matt-garman/mcu-relay-controller/pcb/attiny_v1.1/attiny_relay_bypass_v1.1.BOM.pdf

Ref | Qty | Value | Footprint
C1 | 1 | 10uF | Capacitor_THT:CP_Radial_D5.0mm_P2.50mm
C2 C4 | 2 | 100n | Capacitor_THT:C_Rect_L7.2mm_W3.0mm_P5.00mm_FKS2_FKP2_MKS2_MKP2
C3 | 1 | 10nF | Capacitor_THT:C_Rect_L7.2mm_W2.5mm_P5.00mm_FKS2_FKP2_MKS2_MKP2
R1 R2 R3 | 3 | 1k | Resistor_THT:R_Axial_DIN0207_L6.3mm_D2.5mm_P7.62mm_Horizontal
CLR1 | 1 | 10-15k | Resistor_THT:R_Axial_DIN0207_L6.3mm_D2.5mm_P7.62mm_Horizontal
D1 | 1 | 1N5817 | Diode_THT:D_DO-35_SOD27_P7.62mm_Horizontal
LED1 | 1 | LOW CURRENT/ULTRA BRIGHT mng_footprints:OffboardWireHoles_1x02_P2.54mm
K1 | 1 | Relay_DTDT_A-4.5W-K_separated mng_footprints:Relay_DPDT_A-4.5W-K
Q1 | 1 | 2N7000 | Package_TO_SOT_THT:TO-92_Inline_Wide
SW1 | 1 | SW_SPST | mng_footprints:OffboardWireHoles_1x02_P2.54mm
U1 | 1 | LP2950-5.0_TO92Package_TO_SOT_THT:TO-92_Wide
U2 | 1 | ATtiny85-20P | Package_DIP:DIP-8_W7.62mm
