matt-garman/mcu-relay-controller/pcb/attiny_v1.0/attiny_relay_bypass_v1.0_BOM.pdf

ATtiny relay bypass PCB v1.0

Ref | Qty | Value
C1 | 1 | 10uF
C2 | 1 | 100n
C3 | 1 | 1nF
D1 | 1 | 1N5817
LED1 | 1 | LOW CURRENT/ULTRA BRIGHT
R1 R2 | 2 | 1k
R3 | 1 | 10k
CLR1 | 1 | 10-15k
SW1 | 1 | SW_SPST
Q1 | 1 | 2N3904
U1 | 1 | LP2950-5.0_TO92
U2 | 1 | ATtiny85 (or ATtiny13A)
K1 | 1 | TQ2-L-5V (or AL5WN-K)
