matt-garman/mcu-relay-controller/pcb/attiny_smd_v5.x/attiny_relay_bypass_v5.1.schematic.pdf

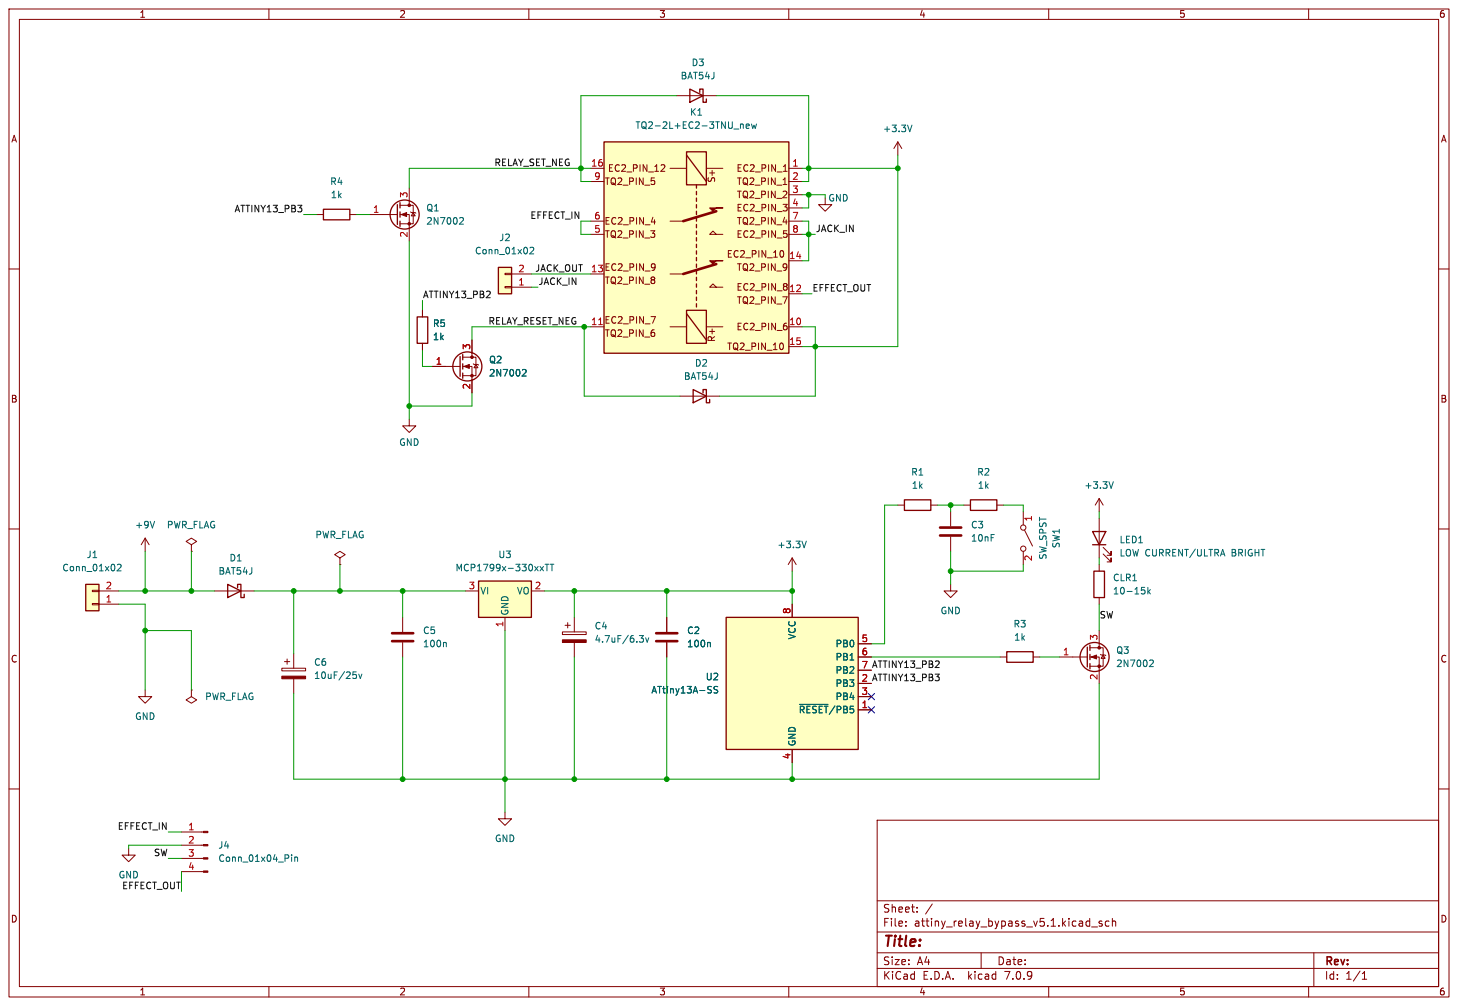
[picture p1: page 1]

LOW CURRENT/ULTRA BRIGHT
