matt-garman/mcu-relay-controller/pcb/pic10f32x_v3.0/pic10f320_relay_bypass_v3.0_schematic.pdf

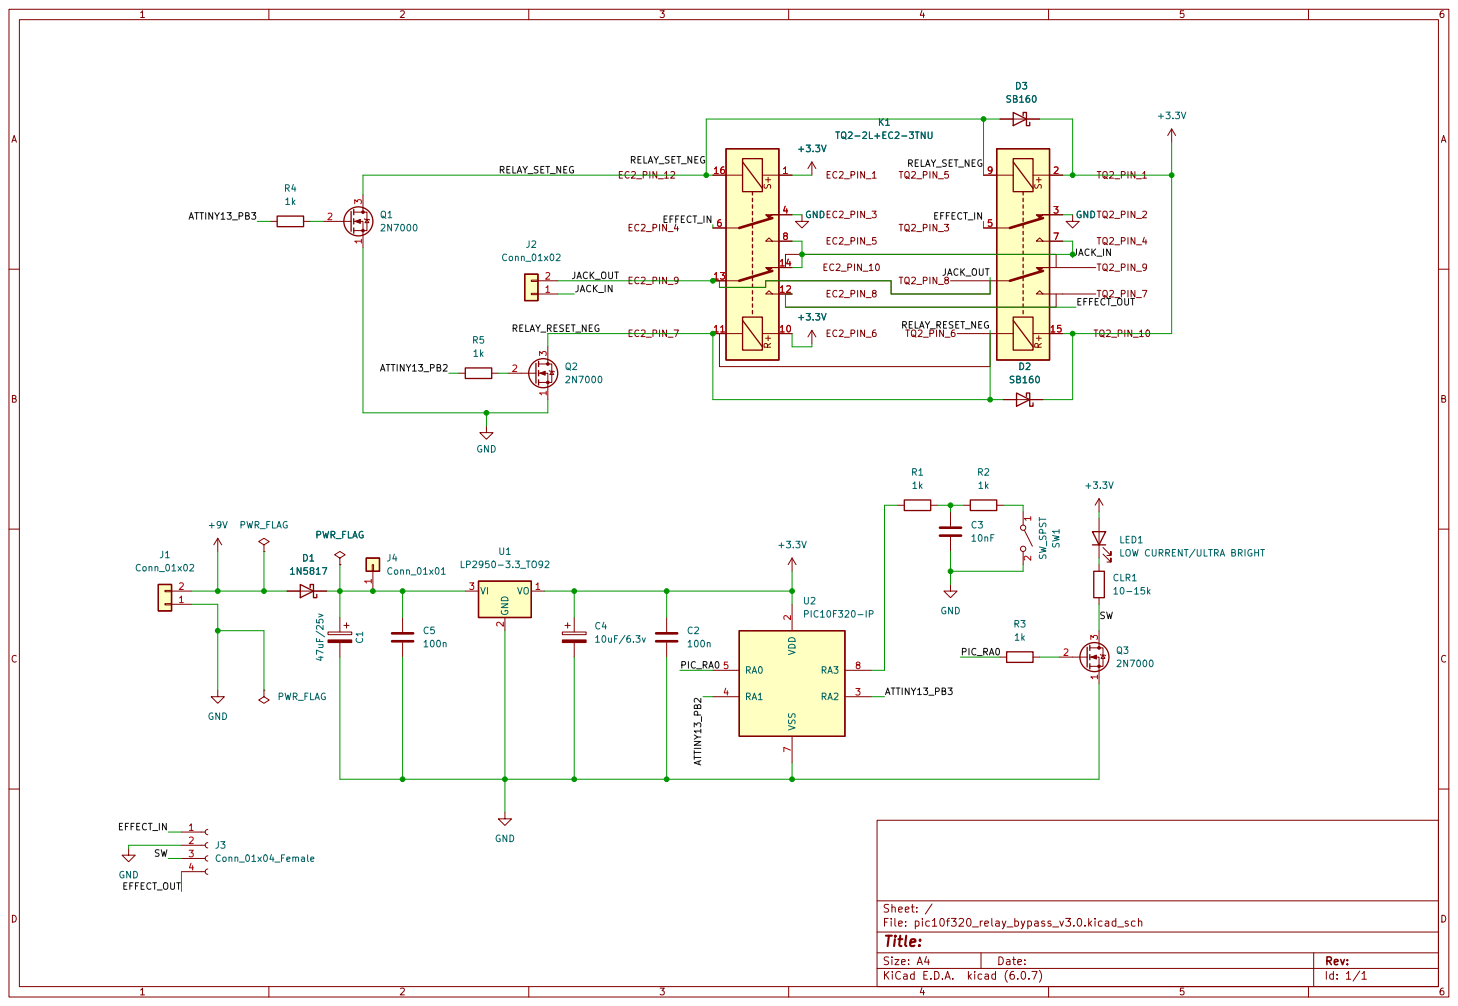
[picture p2: page 1]

LED1
LOW CURRENT/ULTRA BRIGHT
