matt-garman/mcu-relay-controller/pcb/attiny_v2.0/attiny_relay_bypass_v2.0_schematic.pdf

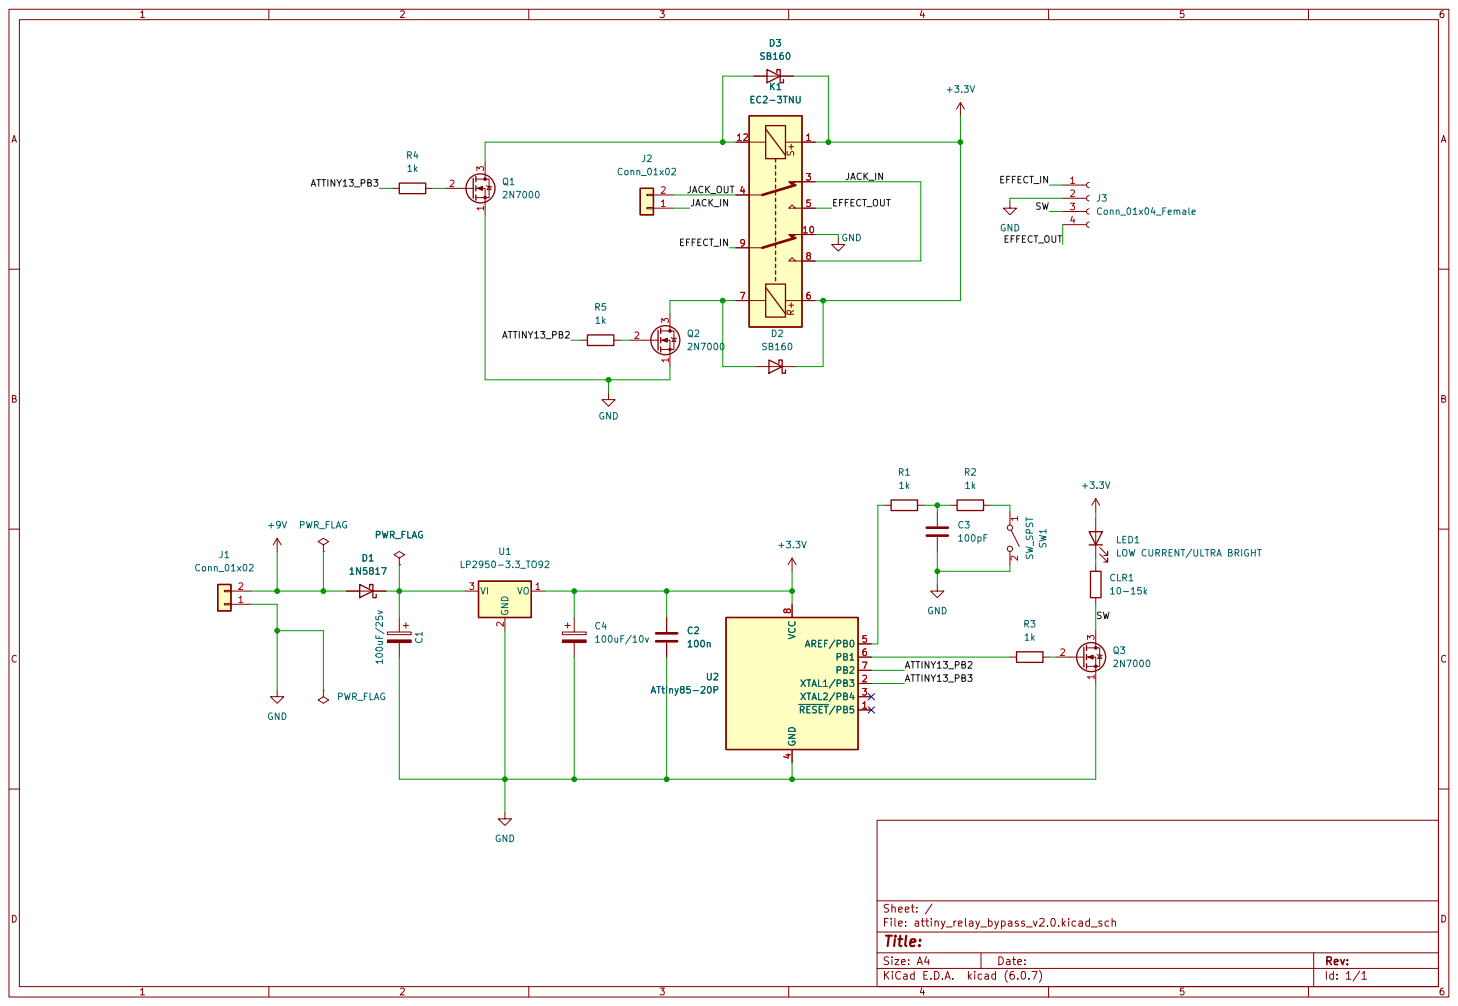
[picture p3: page 1]

LOW CURRENT/ULTRA BRIGHT R5
