matt-garman/mcu-relay-controller/pcb/pic10f32x_v3.0/pic10f32x_relay_bypass_v3.0_BOM.pdf

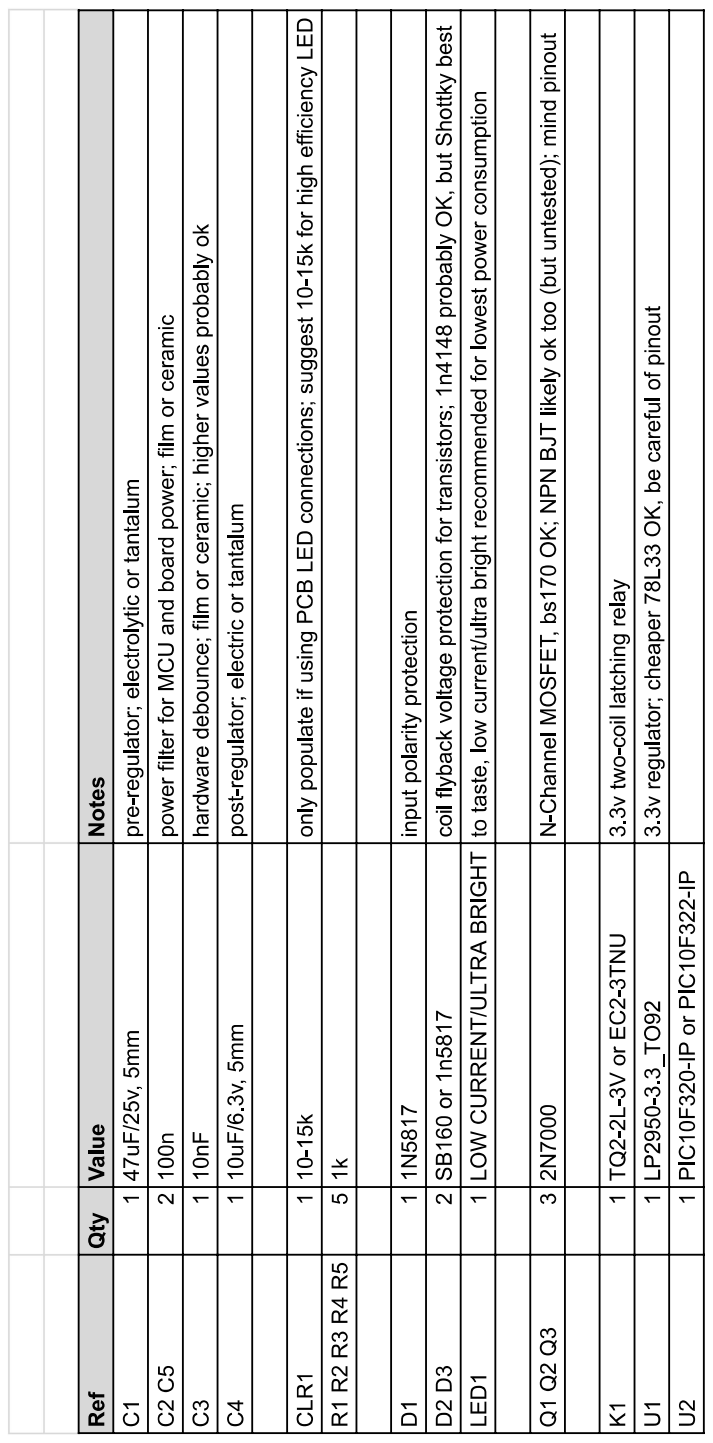
[picture p4: page 1]
