matt-garman/mcu-relay-controller/pcb/attiny_v2.0/attiny_relay_bypass_v2.0_BOM.pdf

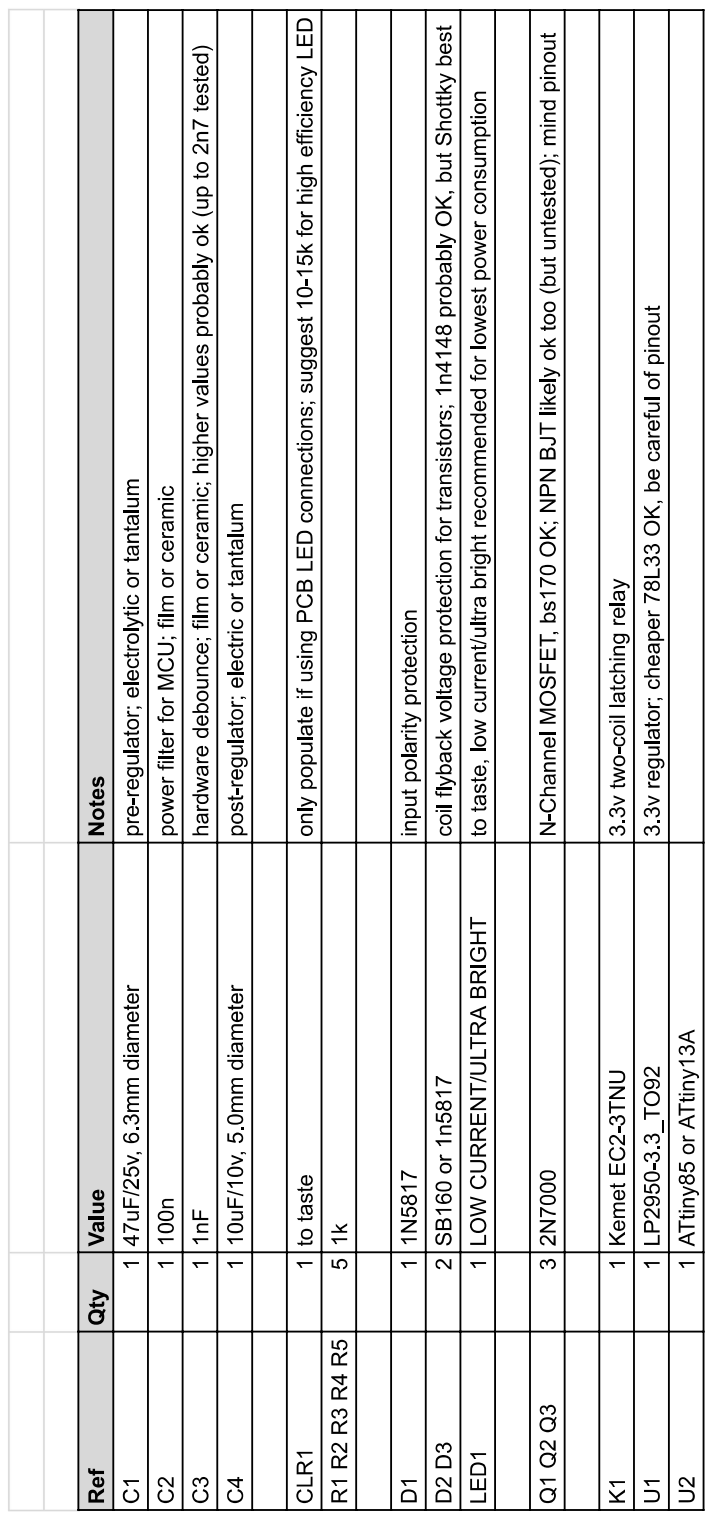
[picture p5: page 1]
