matt-garman/mcu-relay-controller/pcb/attiny_v1.1/attiny_relay_bypass_v1.1_schematic.pdf

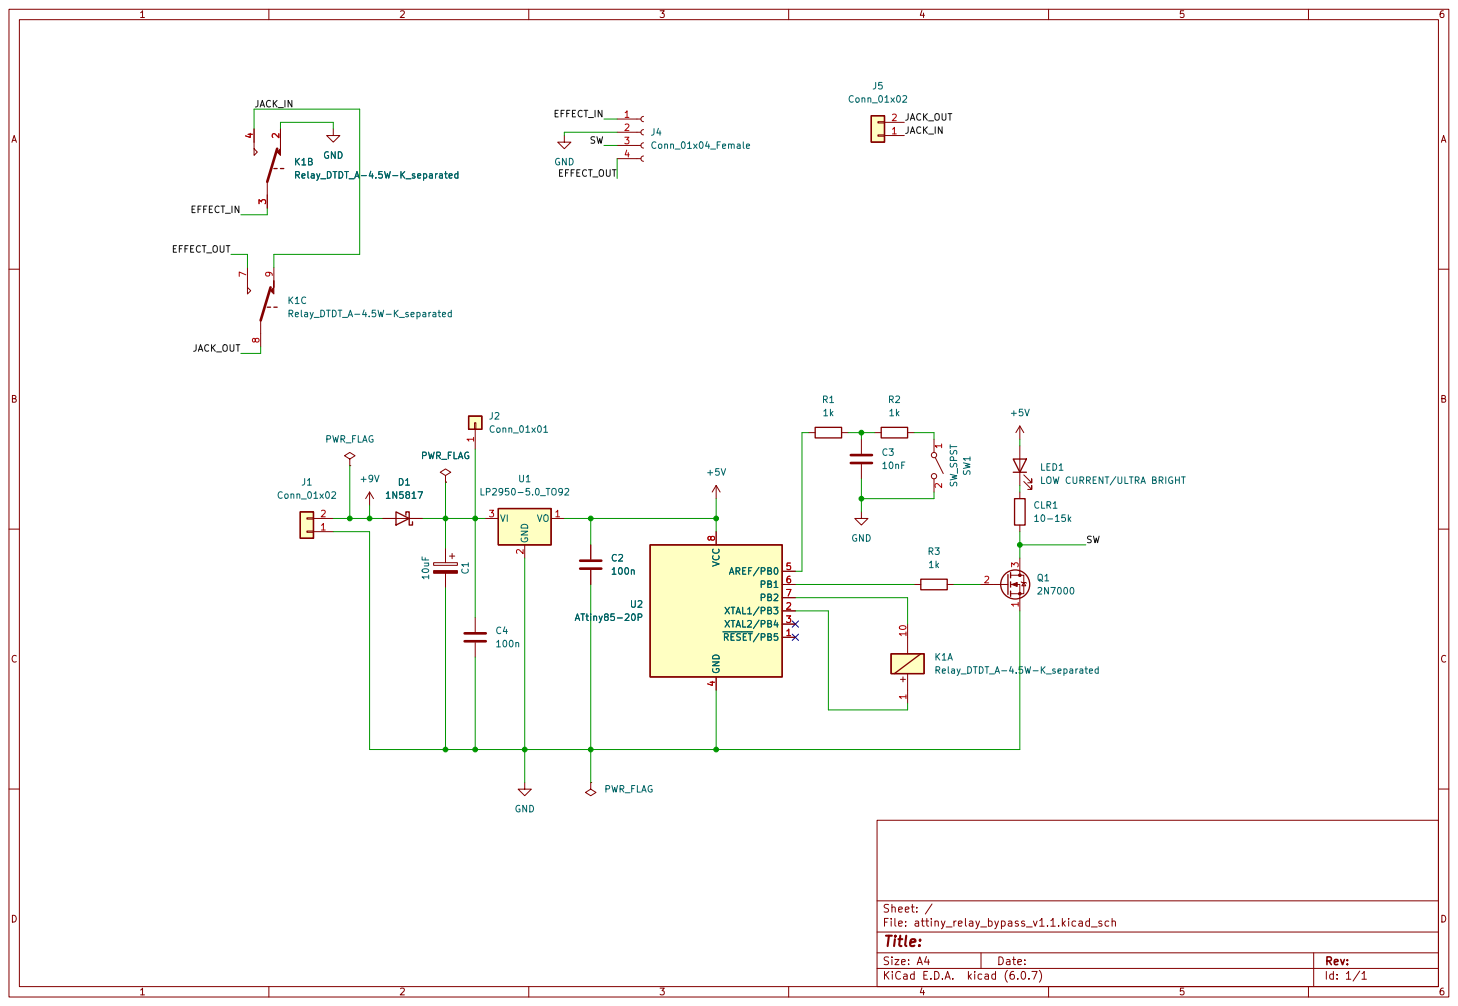
[picture p6: page 1]

LOW CURRENT/ULTRA BRIGHT R2
