matt-garman/mcu-relay-controller/pcb/attiny_v1.0/attiny_relay_bypass_v1.0_schematic.pdf

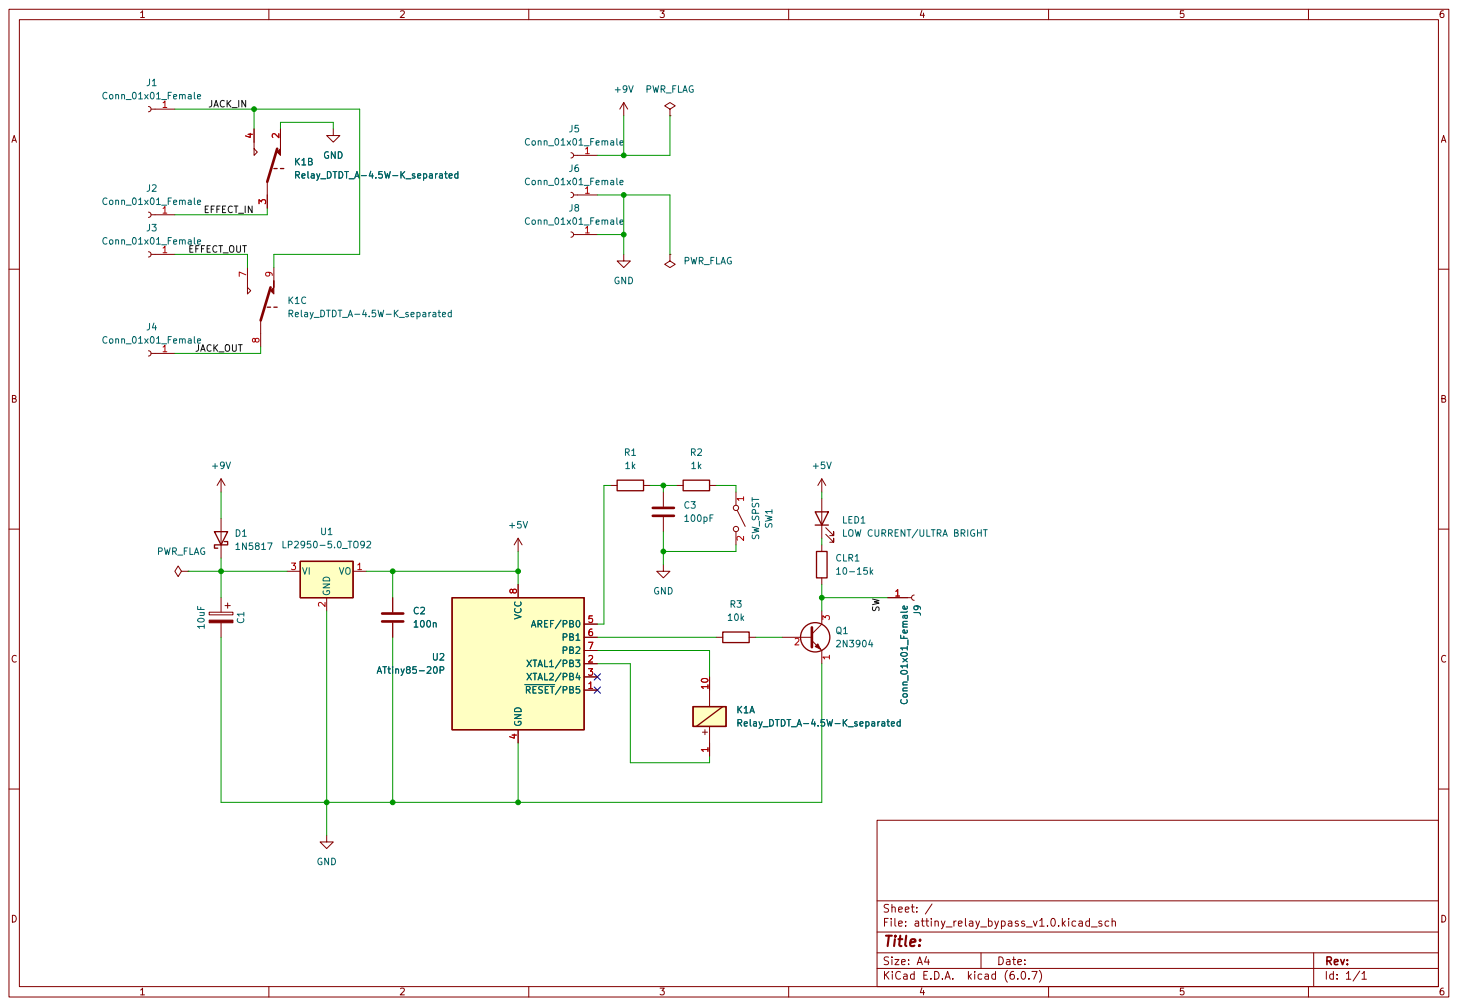
[picture p7: page 1]

LOW CURRENT/ULTRA BRIGHT C1 10uF
