matt-garman/mcu-relay-controller/(commit log)

2023-05-05 Add link to switch debounce routine blog post
2023-05-07 fix "direct function call made with an incomplete prototype" warnings in xc8
    [attiny.c, mcu-relay-controller-iface.h, mcu-relay-controller.c, pic12f675.c]
2023-05-07 fix fail to wake from sleep on pin change
    [pic12f675.c]
2023-05-10 update readme supported devices
2023-05-15 increase relay settle time to 10ms
2023-05-31 Update debounce code, xc8 compile fixes
    [mcu-relay-controller-iface.h, mcu-relay-controller.c]
2023-05-31 bugfix: swap HIGH and LOW
    [attiny.c]
2023-05-31 Added Gerber, BOM and Schematic for PCB v1.0
2023-06-12 added PCB v2.0 gerbers
2023-06-12 add PCB v2.0 schematic and BOM
2023-06-22 pcb v3.0 gerber and schematic
2023-07-13 created section describing PCB revisions
2023-07-30 add pcb v3.0 BOM
2024-01-03 update README w/v5.x; add schematics and gerbers
2024-01-28 add ATtiny v1.1 BOM
